colinfriedel/jvc-carplay-remote/docs/images/wiring-diagram.png

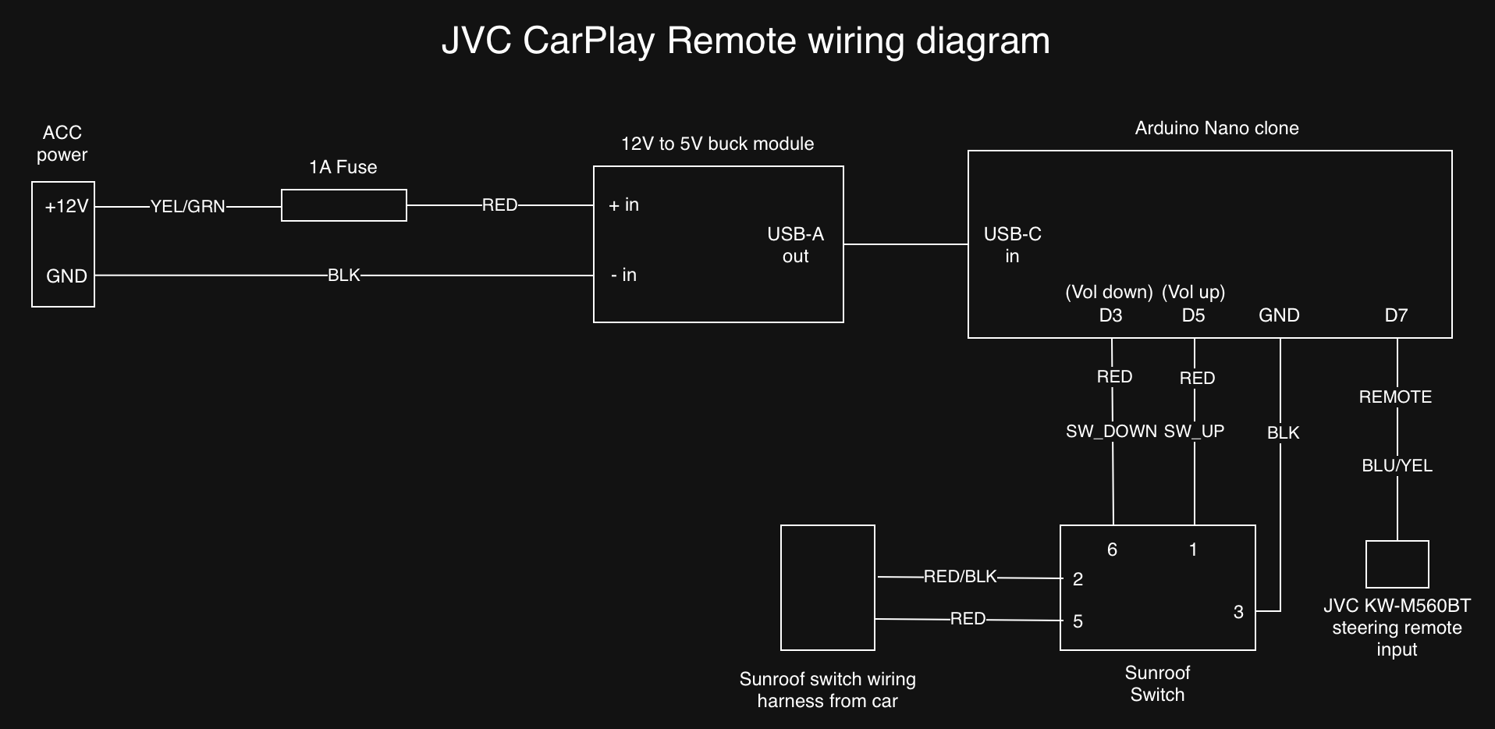
docs/images/wiring-diagram.png
