colinfriedel/jvc-carplay-remote/(commit log)

2026-10-05 Added photo of installed switch
2026-10-05 Replace installed switch photo
2026-10-05 Add lines for KiCad caches to .gitignore
2026-10-07 Include wiring diagram in README
    Added wiring diagram image to README.
2026-10-07 Include wiring diagram for Arduino project
    Added a wiring diagram flowchart to the README.
2026-10-07 Add wiring diagram
2026-10-07 adding white background wiring diagram
2026-10-07 Fix mermaid code block and update wiring diagram image
    Updated mermaid syntax and changed wiring diagram image.
2026-10-07 Enhance README with project details and wiring info
    Updated README with clearer descriptions and added gesture control details.
2026-10-07 Clarify head unit ground and update code sourcing details
    Updated the README to clarify the head unit's ground connection and improved wording for the code sourcing section.
